Pletacka-IoT/Pletacka-board/README.md

# Pletacka-boad

## [Version 2.0](Pletacka-board-v2.0/README.md)

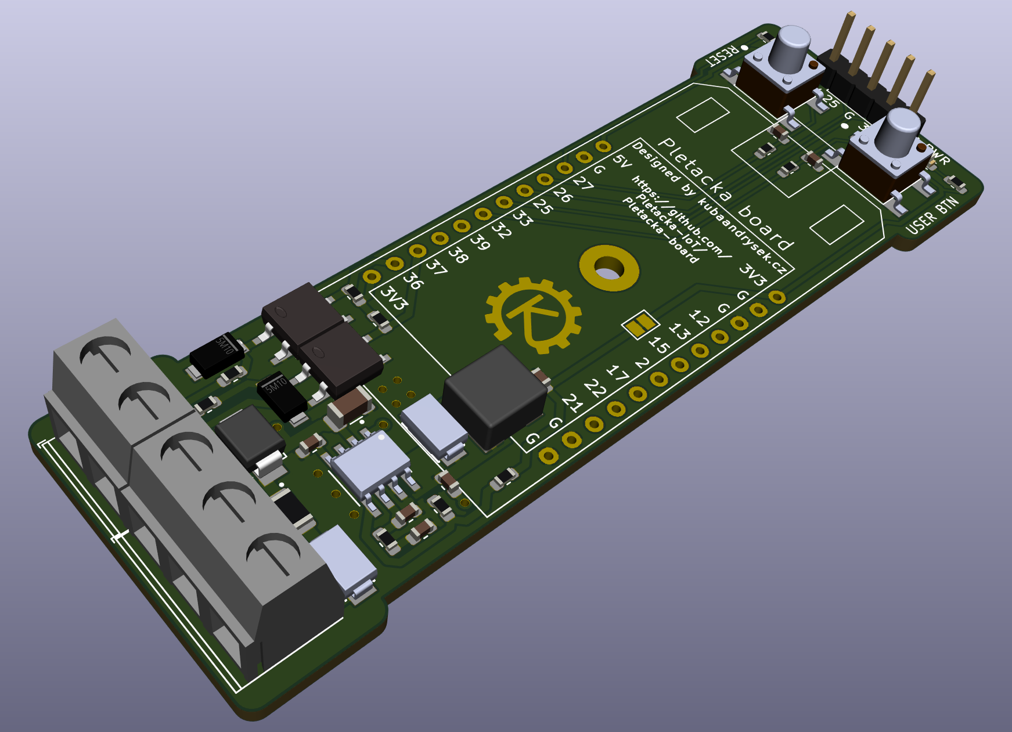
[picture p1: Pletacka-board-v2.0/media/P0.png]
Front

# [All photos](./Pletacka-board-v2.0/media/README.md)
