Pletacka-IoT/Pletacka-board/Pletacka-board-v2.0/README.md

# Pletacka-boad v2.0

## Export manufacturing data - Linux

Run `make` in console 

### Required packages
 - [KiKit](https://github.com/yaqwsx/KiKit#installation) Automation for KiCAD
 - [Python 3](https://www.python.org/downloads/)
