Pletacka-IoT/Pletacka-board/Pletacka-board-v2.0/media/README.md

## Version 2.0 - Images

Front
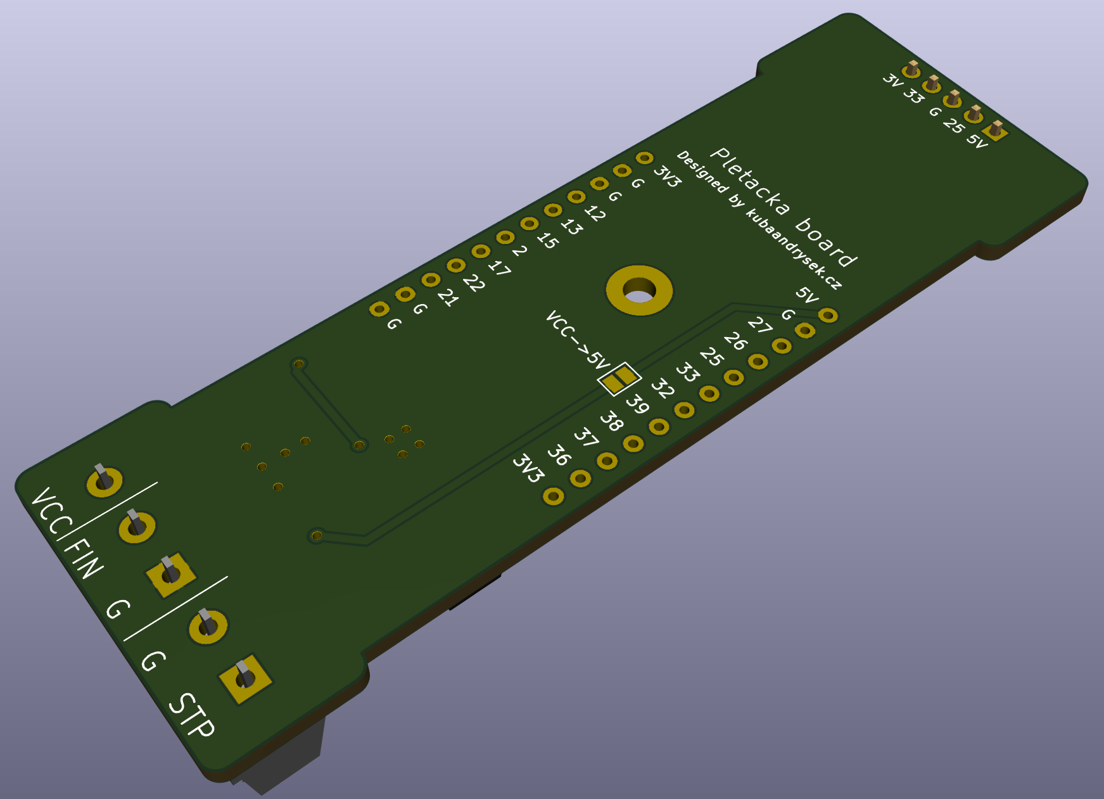
[picture p2: Pletacka-board-v2.0/media/P5.png]
Back


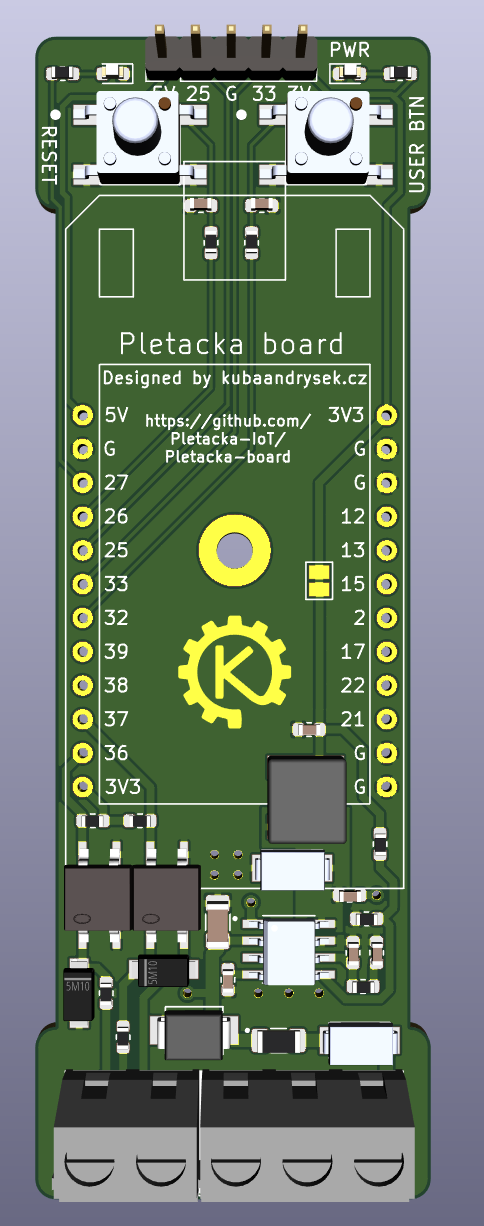
[picture p3: Pletacka-board-v2.0/media/P1.png]

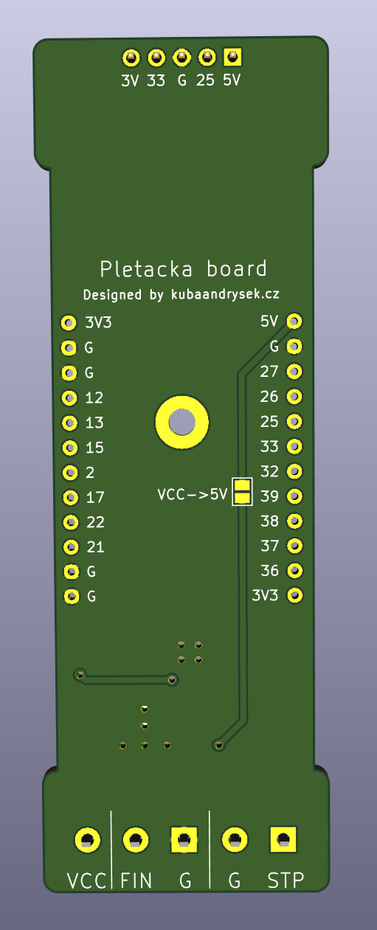
[picture p4: Pletacka-board-v2.0/media/P6.png]


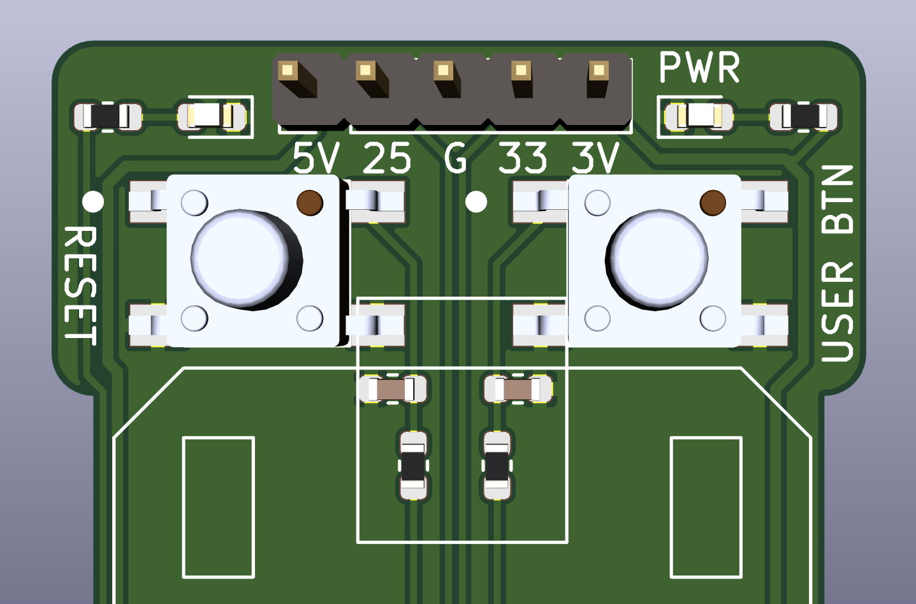
[picture p5: Pletacka-board-v2.0/media/P4.png]

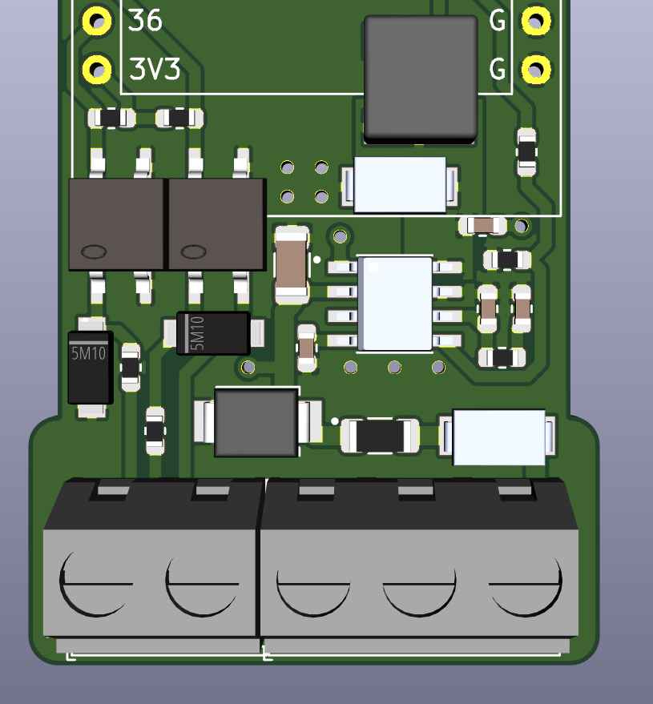
[picture p6: Pletacka-board-v2.0/media/P2.png]

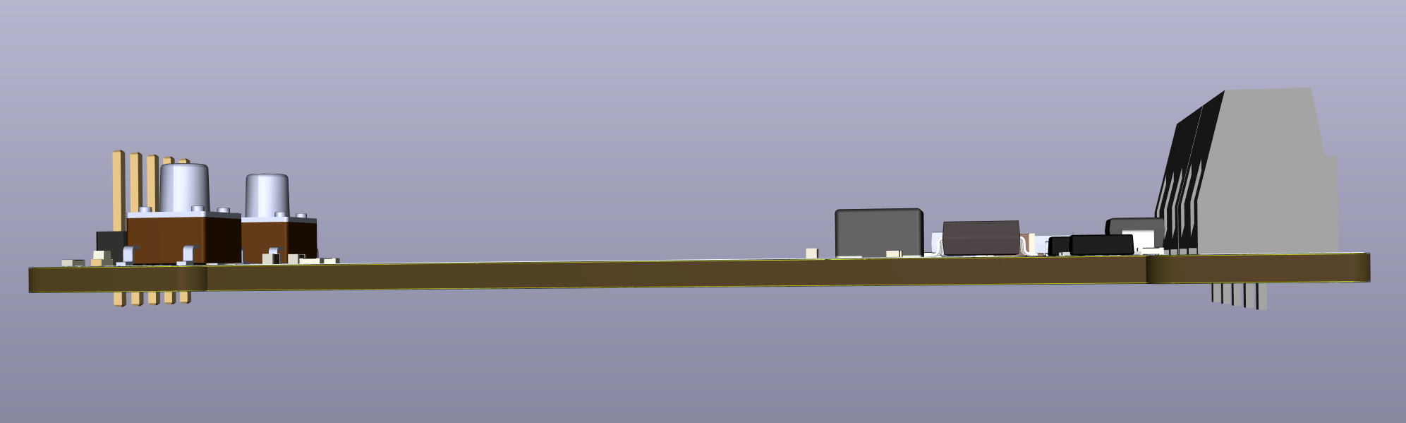
[picture p7: Pletacka-board-v2.0/media/P7.png]
