Pletacka-IoT/Pletacka-board/Pletacka-board-v2.0/media/P3.png

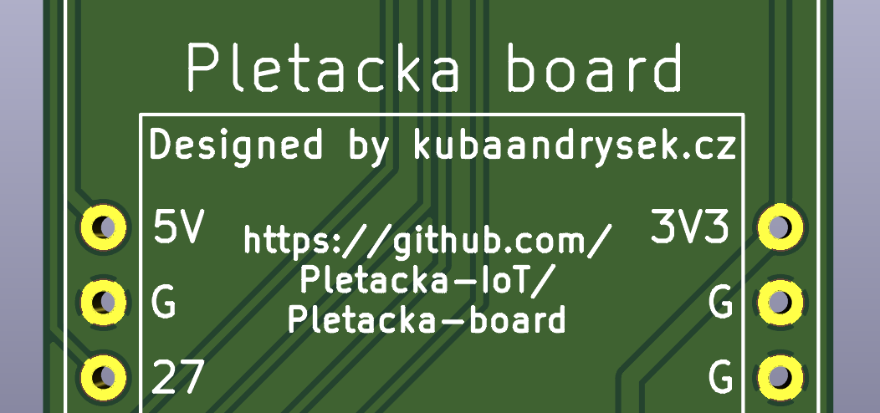
Pletacka-board-v2.0/media/P3.png
