Pletacka-IoT/Pletacka-board/Pletacka-board-v2.0/media/Pletacka_board-V2.png

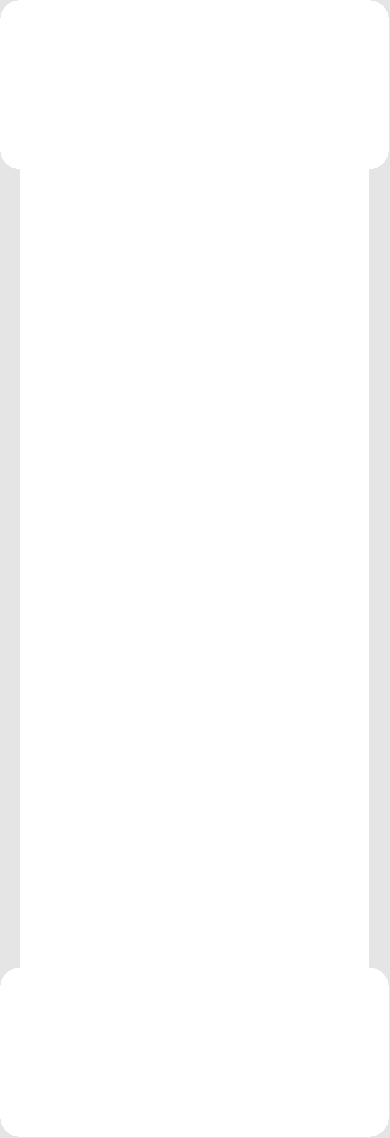
Pletacka-board-v2.0/media/Pletacka_board-V2.png
