Pletacka-IoT/Pletacka-board/Pletacka-board-v2.0/media/Routing_v2.0-2.png

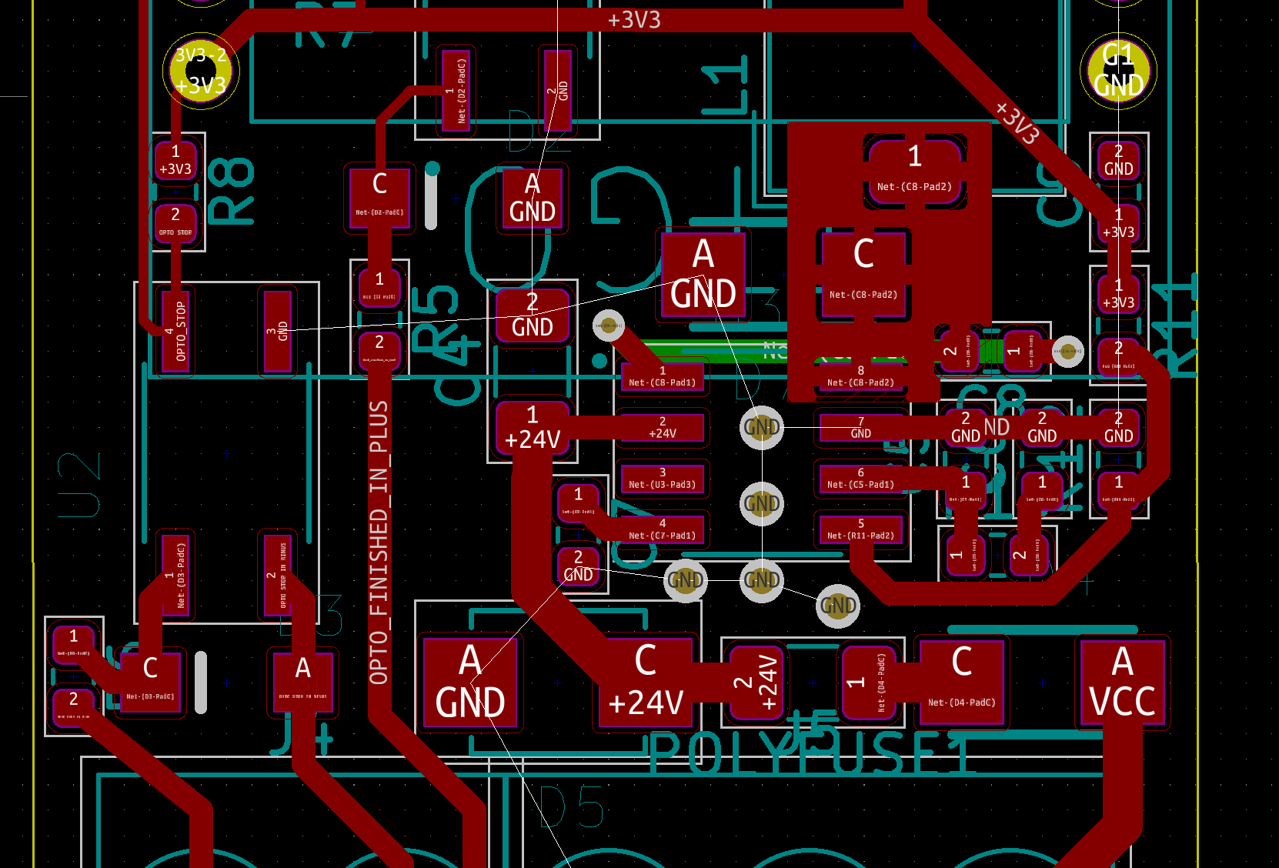
Pletacka-board-v2.0/media/Routing_v2.0-2.png
