Pletacka-IoT/Pletacka-board/Pletacka-board-v2.0/media/V2.0.png

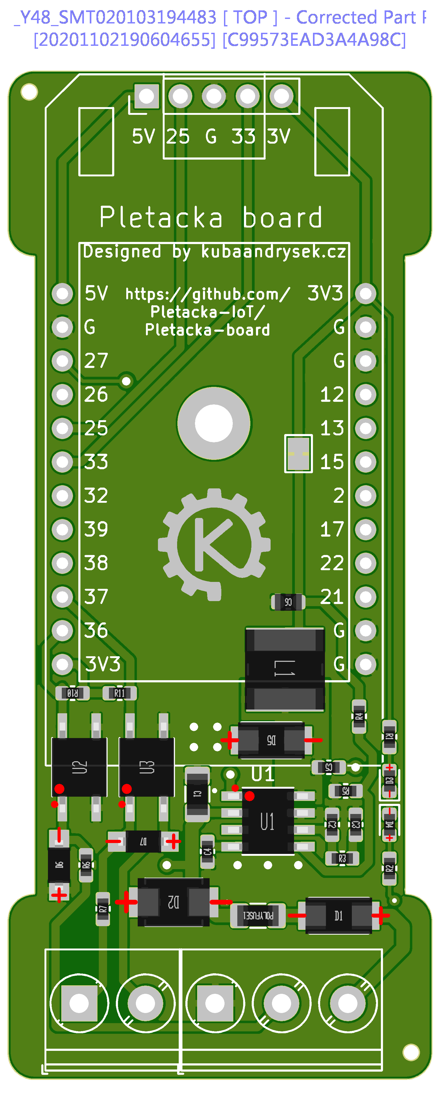
Pletacka-board-v2.0/media/V2.0.png
