Pletacka-IoT/Pletacka-board/Pletacka-board-v2.0/cover/Cover.stl

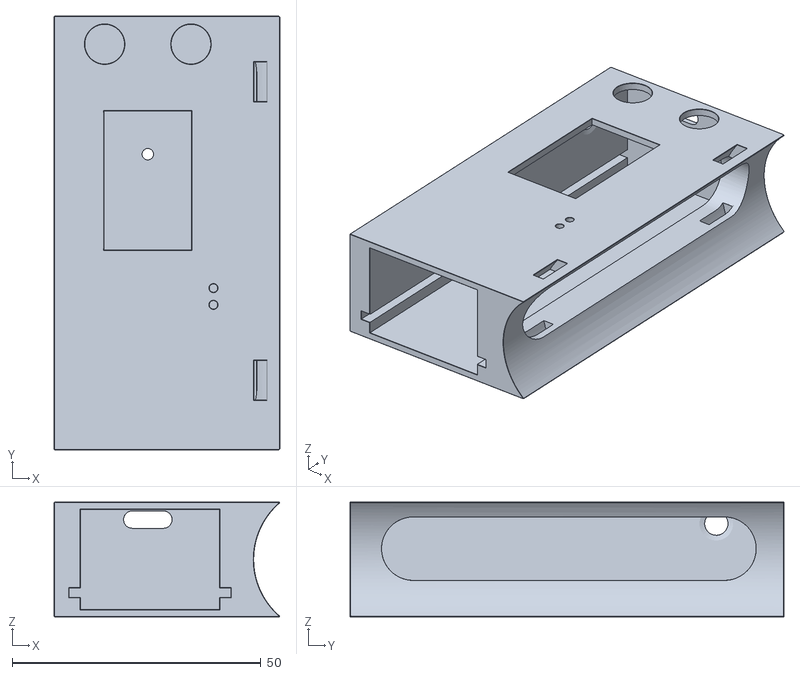
[picture p13: CAD file, 2020-12-12]
Pletacka-board-v2.0/cover/Cover.stl
45.3 x 87.2 x 23.1
