Pletacka-IoT/Pletacka-board/Pletacka-board-v2.0/cover/Button-reset.stl

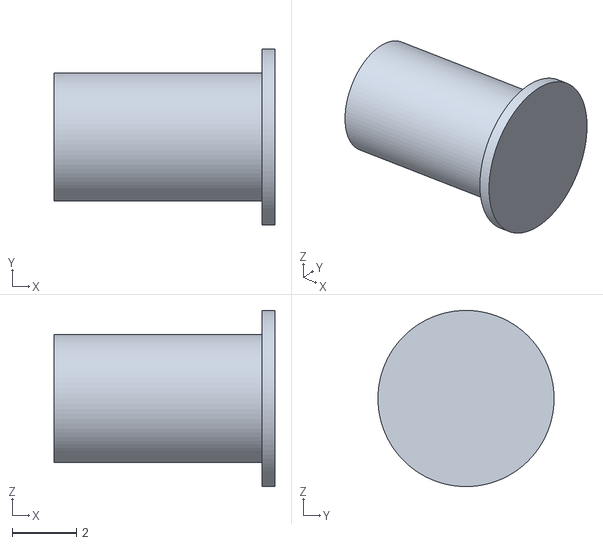
[picture p14: CAD file, 2020-12-12]
Pletacka-board-v2.0/cover/Button-reset.stl
6.90 x 5.50 x 5.50
