Pletacka-IoT/Pletacka-board/Pletacka-board-v2.0/cover/Holder-b.stl

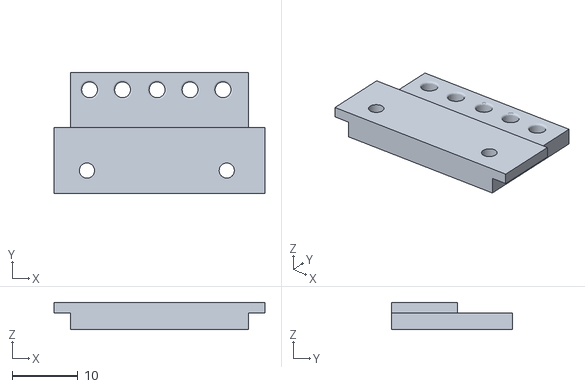
[picture p15: CAD file, 2020-12-12]
Pletacka-board-v2.0/cover/Holder-b.stl
32.0 x 18.4 x 4.10
