Pletacka-IoT/Pletacka-board/Pletacka-board-v2.0/cover/Holder-t.stl

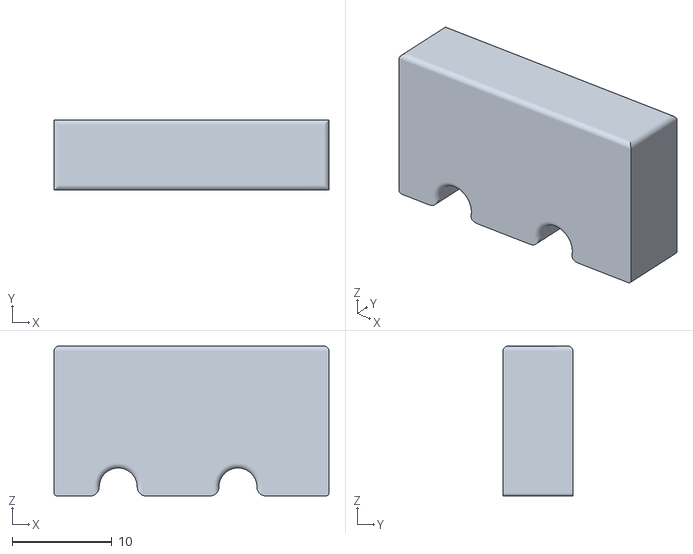
[picture p16: CAD file, 2020-12-12]
Pletacka-board-v2.0/cover/Holder-t.stl
27.5 x 7.00 x 15.0
