Pletacka-IoT/Pletacka-board/Pletacka-board-v2.0/cover/Button.stl

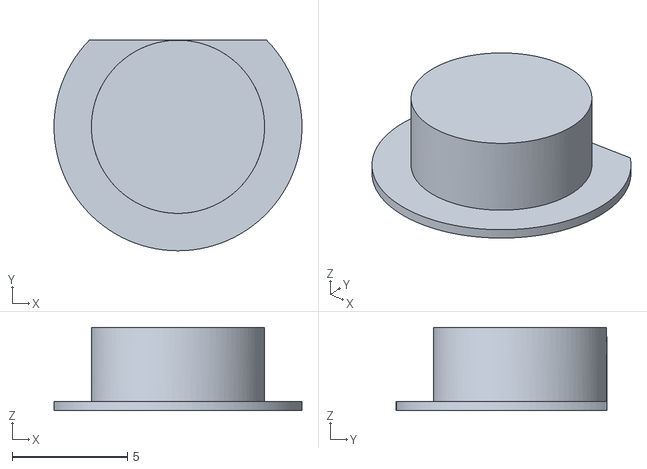
[picture p17: CAD file, 2020-12-12]
Pletacka-board-v2.0/cover/Button.stl
10.7 x 9.12 x 3.60
