Pletacka-IoT/Pletacka-board/Pletacka-board-v1.0/cover/3-covers-assembly.3mf

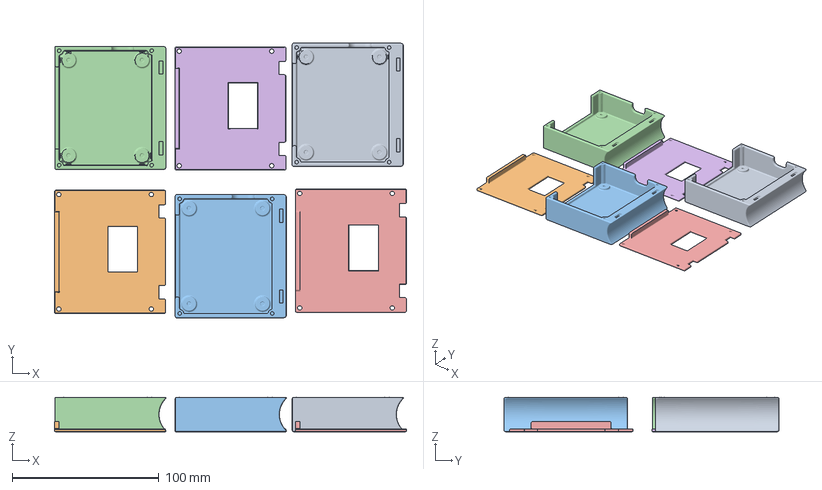
[picture p18: CAD file, 2020-10-28, an earlier design]
Pletacka-board-v1.0/cover/3-covers-assembly.3mf
239.8 x 187.1 x 23.5 mm
Cover.stl x 3
Cover-Top.stl x 3
