Pletacka-IoT/Pletacka-board/Pletacka-board-v1.0/cover/1-cover-assembly.3mf

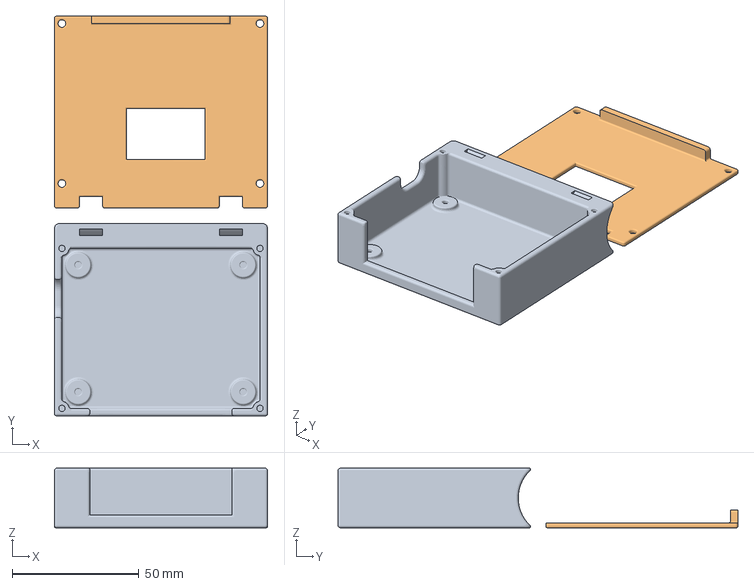
[picture p19: CAD file, 2020-10-24, an earlier design]
Pletacka-board-v1.0/cover/1-cover-assembly.3mf
84.0 x 157.5 x 23.5 mm
Cover.stl
Cover-Top.stl
