Pletacka-IoT/Pletacka-board/Pletacka-board-v1.0/cover/Cover-Top.stl

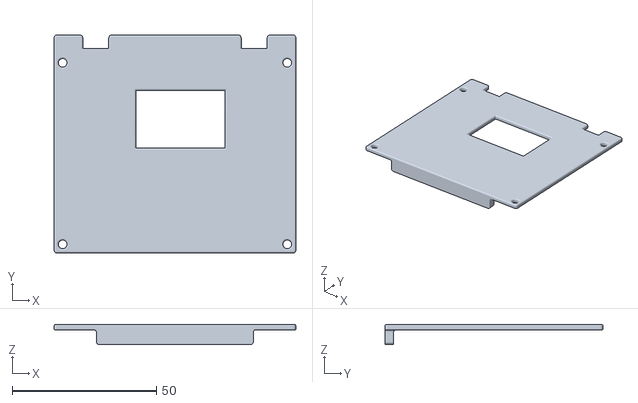
[picture p20: CAD file, 2020-10-24, an earlier design]
Pletacka-board-v1.0/cover/Cover-Top.stl
84.0 x 75.7 x 7.00
