Pletacka-IoT/Pletacka-board/Pletacka-board-v1.0/cover/Cover.stl

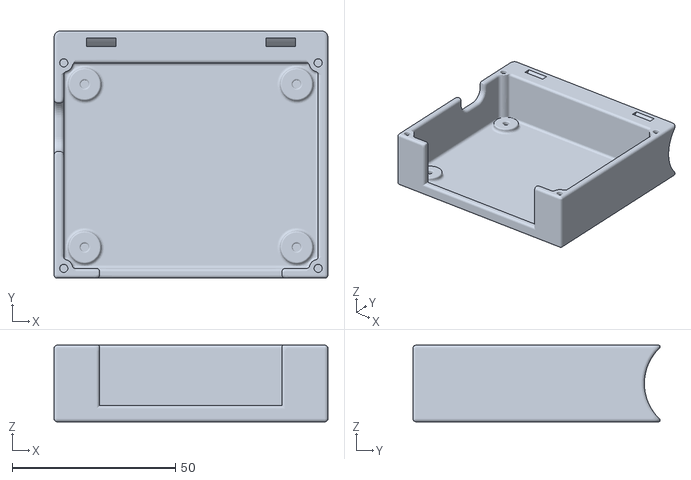
[picture p21: CAD file, 2020-10-24, an earlier design]
Pletacka-board-v1.0/cover/Cover.stl
84.0 x 75.8 x 23.5
