Pletacka-IoT/Pletacka-board/(threads)

Thread 10 (2020-08-10):

Restrict around mounting holes only from one side

cednik, 2020-08-10:
Is it okay?

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

JakubAndrysek, 2020-08-11:
Fixed

Closed 2020-08-11.

Thread 11 (2020-08-10):

Add JLCPCB order number and tooling holes

cednik, 2020-08-10:
Consider add [location of JLCPCB order number](https://support.jlcpcb.com/article/28-how-to-put-jlc-production-id-at-a-specified-area-on-the-pcb) and [SMT assembly Tooling holes](https://support.jlcpcb.com/article/92-how-to-add-tooling-holes-for-smt-assembly-order).

Closed 2020-08-11.

Thread 13 (2020-08-10):

Step-down undorvoltage threshold

cednik, 2020-08-10:
Step-down undorvoltage threshold is set to 13.75 V (by R14 and R15). Is it correct?

JakubAndrysek, 2020-08-11:
Is it correct?
What voltage you would recommended.

JakubAndrysek, 2020-08-12:
Fixed

Closed 2020-08-12.

Thread 14 (2020-08-10):

Missing pull-up resistors on I2C

cednik, 2020-08-10:
I suggest to add them.

Closed 2020-08-11.

Thread 15 (2020-08-10):

USB not at the board edge

cednik, 2020-08-10:
In case of boxing the device, USB connector should be at the board edge.

JakubAndrysek, 2020-08-11:
I will fix it in the next version

Thread 2 (2020-08-10):

Inssuficient power rating of input resistors

cednik, 2020-08-10:
Expected input voltage U = 24 V
Figure 1 in the [optocoupler datasheet](https://datasheet.lcsc.com/szlcsc/Everlight-Elec-EL357N-B-TA-G_C6649.pdf) shows Forward voltage Vf ≈ 1.2 V @ 10 mA (24 V / 2 kΩ).
So power loss on the input resistor (R6, R8, R10, R12) P = (U - Vf)² × R = (24 - 1.2)² × 2000 = 259.92 mW, which is more then designed 0.25 W!
The situation is even worse in case of reversed polarity - voltage drop accros diode B5819W is smaller.

**Suggestion:**
Lower the emitor current to only 1 mA.

Closed 2020-08-10.

Thread 3 (2020-08-10):

Insufficient voltage rating of step-down output capacitor

cednik, 2020-08-10:
Read [this](https://www.murata.com/en-global/products/%20emiconfun/capacitor/2012/11/28/en-20121128-p1) article from [Murata](https://www.murata.com/) (major capacitors vendor).

This is Capacitance change rate vs. DC bias voltage characteristics of 6.3 V capacitor. Especially blue line - your case.
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
[[1](https://www.murata.com/-/media/webrenewal/products/emiconfun/capacitor/2012/11/28/en-20121128-p1/en-20121128-p1_img0001.ashx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)]
You can see that at 5 V the capacitor has only half of it's nominal capacity.

**Suggestion**
Use capacitor rated at least at 16 V.

Closed 2020-08-10.

Thread 7 (2020-08-10):

Power LED should be on by default

cednik, 2020-08-10:
And ESP can turn it off, but by default it shoult indicate presence of the power.

**Suggestion**
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

JarekParal, 2020-08-10:
There should be PWR LED used as ESP start-up indicator. Not a power indicator.

**Suggestion**
`PWR` -> `ON`

Closed 2020-08-10.
