Pletacka-IoT/Pletacka-board/Pletacka-board-v2.0/hw/Pletacka-board.kicad_pcb

## KiCad design Pletacka-board-v2.0/hw/Pletacka-board.kicad_pcb (2020-10-25)

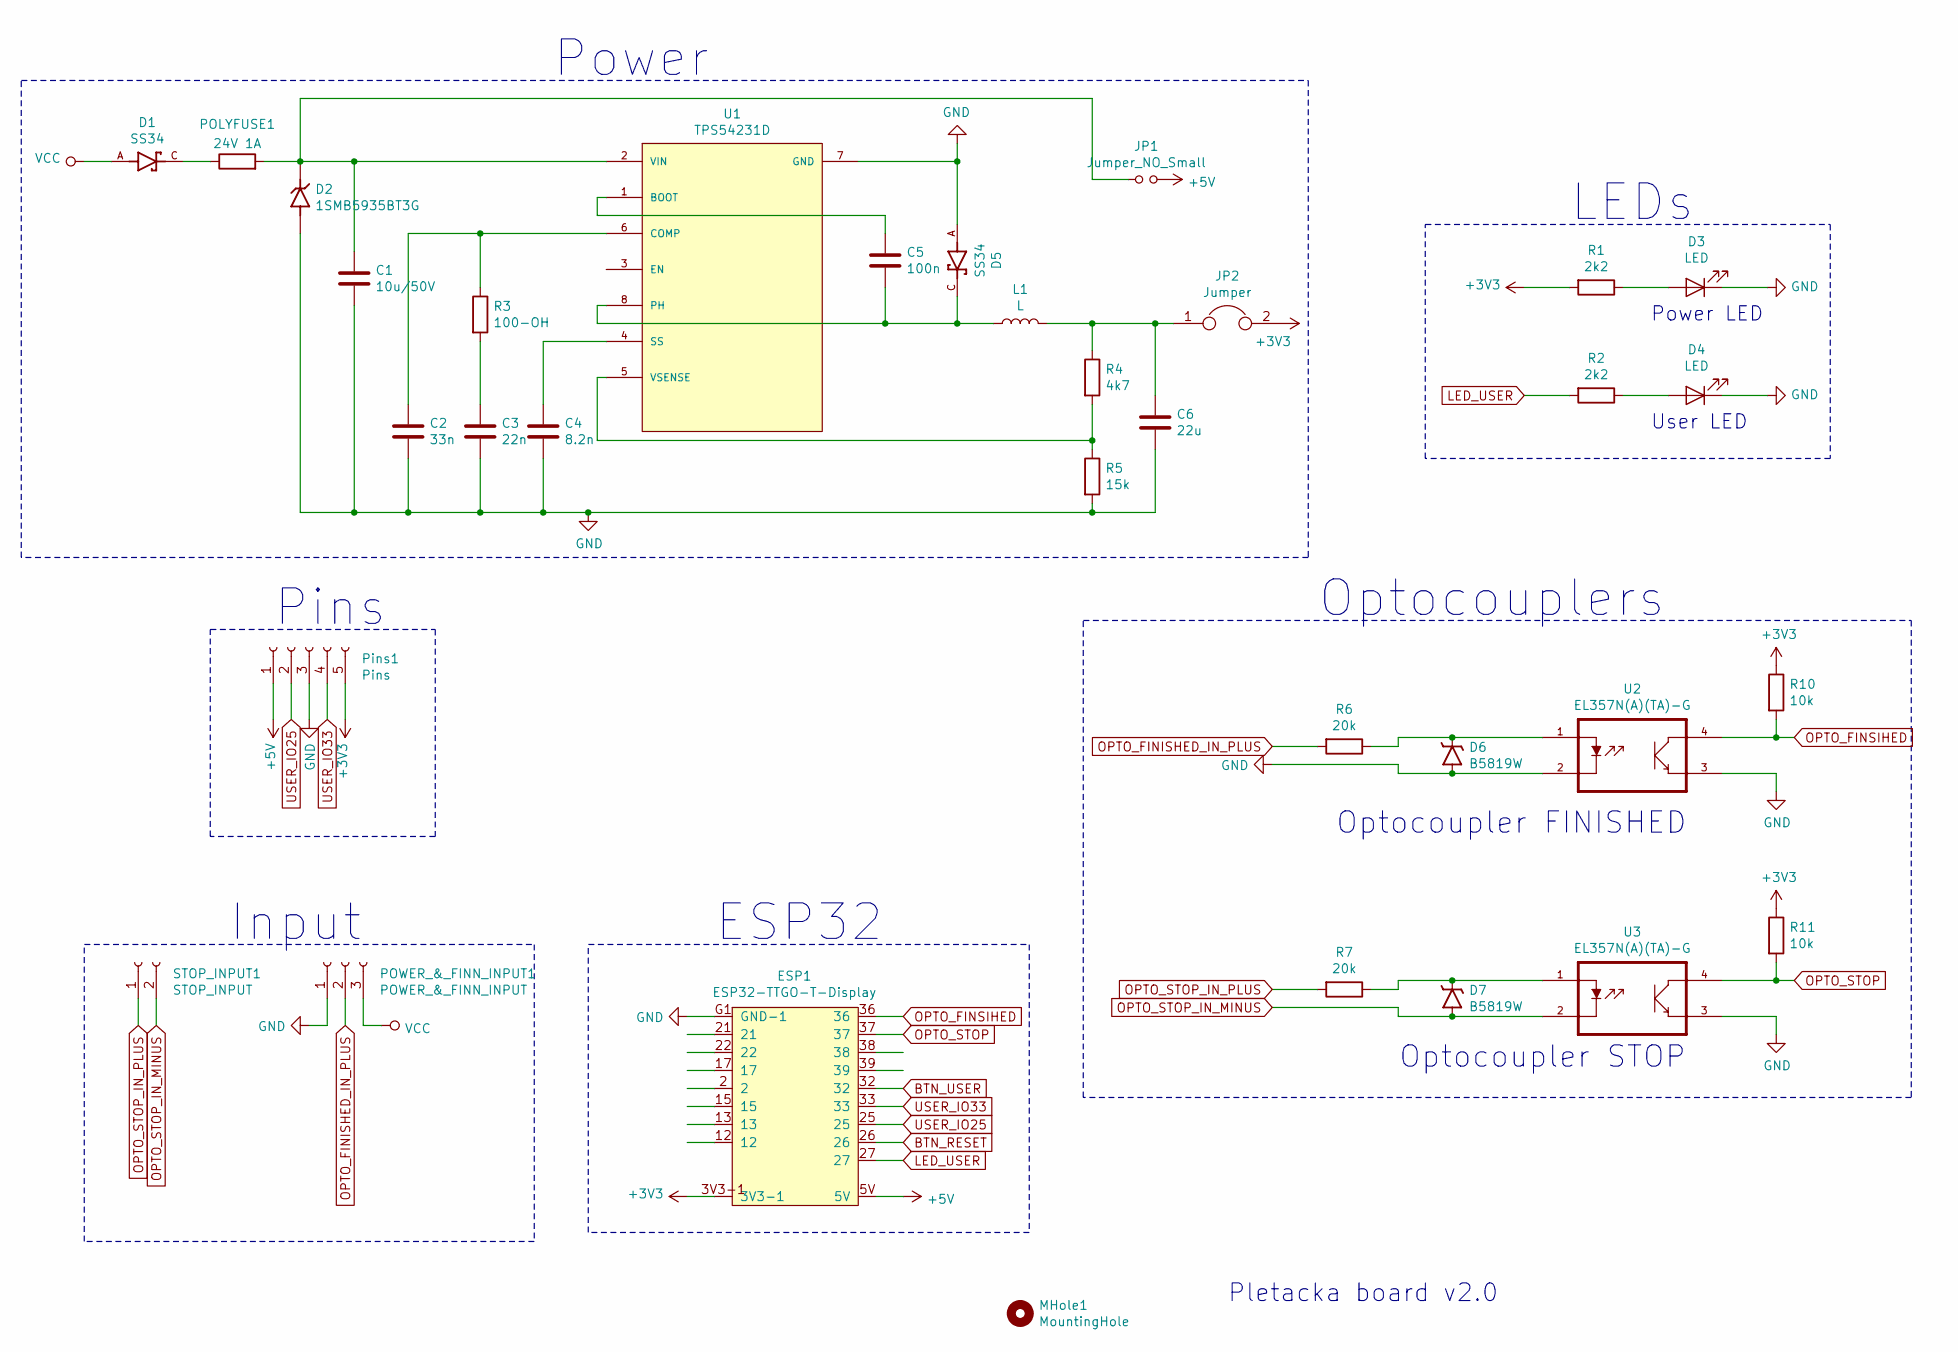
[picture p22: schematic Pletacka-board.sch]

Parts:
C1: 10u/50V; C_1206_3216Metric; LCSC C13585
C2: 33n; C_0603_1608Metric; LCSC C21117
C3: 22n; C_0603_1608Metric; LCSC C21122
C4: 8.2n; C_0603_1608Metric; LCSC C1032
C5: 100n; C_0603_1608Metric; LCSC C14663
C6: 22u; C_0603_1608Metric; LCSC C45783
D1, D5: SS34; SMA; LCSC C8678
D2: 1SMB5935BT3G; DIOM5436X247N; LCSC C49827
D3: LED; LED_0603_1608Metric; LCSC C72043
D4: LED; LED_0603_1608Metric; LCSC C2286
D6, D7: B5819W; B5819W_SOD-123; LCSC C8598
ESP1: ESP32-TTGO-T-Display
JP1: Jumper_NO_Small; SolderJumper-2_P1.3mm_Open_Pad1.0x1.5mm
JP2: Jumper; SolderJumper-2_P1.3mm_Bridged_Pad1.0x1.5mm
L1: L; SLW; LCSC C206321
MHole1: MountingHole; MountingHole_2.7mm_M2.5_Pad
POLYFUSE1: 24V 1A; R_1206_3216Metric; LCSC C70076
POWER_&_FINN_INPUT1: POWER_&_FINN_INPUT; TerminalBlock_Phoenix_PT-1,5-3-5.0-H_1x03_P5.00mm_Horizontal
Pins1: Pins; PinHeader_1x05_P2.54mm_Vertical
R1, R2: 2k2; R_0603_1608Metric; LCSC C4190
R3: 100-OH; R_0603_1608Metric; LCSC C22775
R4: 4k7; R_0603_1608Metric; LCSC C23162
R5: 15k; R_0603_1608Metric; LCSC C22809
R6, R7: 20k; R_0603_1608Metric; LCSC C4184
R10, R11: 10k; R_0603_1608Metric; LCSC C25804
STOP_INPUT1: STOP_INPUT; TerminalBlock_Phoenix_PT-1,5-2-5.0-H_1x02_P5.00mm_Horizontal
U1: TPS54231D; SOIC127P599X175-8N; LCSC C9865
U2, U3: EL357N(A)(TA)-G; SOP254P700X200-4N; LCSC C6649

Connections:
+3V3: ESP1.3V3-1, ESP1.3V3-2, JP2.2, Pins1.5, R1.2, R10.1, R11.1
+5V: ESP1.5V, JP1.2, Pins1.1
BTN_RESET: ESP1.26
BTN_USER: ESP1.32
GND: C1.2, C2.2, C3.2, C4.2, C6.2, D2.A, D3.1 (K), D4.1 (K), D5.A, D6.A, ESP1.G1 (GND-1), ESP1.G2 (GND-2), ESP1.G3 (GND-3), ESP1.G4 (GND-4), ESP1.G5 (GND-5), POWER_&_FINN_INPUT1.1, Pins1.3, R5.2, U1.7 (GND), U2.2, U2.3, U3.3
LED_USER: ESP1.27, R2.2
unnamed: C1.1, D2.C, JP1.1, POLYFUSE1.2, U1.2 (VIN)
unnamed: C2.1, R3.1, U1.6 (COMP)
unnamed: C3.1, R3.2
unnamed: C4.1, U1.4 (SS)
unnamed: C5.1, U1.1 (BOOT)
unnamed: C5.2, D5.C, L1.1, U1.8 (PH)
unnamed: C6.1, JP2.1, L1.2, R4.1
unnamed: D1.C, POLYFUSE1.1
unnamed: D3.2 (A), R1.1
unnamed: D4.2 (A), R2.1
unnamed: D6.C, R6.1, U2.1
unnamed: D7.C, R7.1, U3.1
unnamed: R4.2, R5.1, U1.5 (VSENSE)
OPTO_FINISHED_IN_PLUS: POWER_&_FINN_INPUT1.2, R6.2
OPTO_FINSIHED: ESP1.36, R10.2, U2.4
OPTO_STOP: ESP1.37, R11.2, U3.4
OPTO_STOP_IN_MINUS: D7.A, STOP_INPUT1.2, U3.2
OPTO_STOP_IN_PLUS: R7.2, STOP_INPUT1.1
USER_IO25: ESP1.25, Pins1.2
USER_IO33: ESP1.33, Pins1.4
VCC: D1.A, POWER_&_FINN_INPUT1.3

Notes on the sheet:
Input
Optocoupler FINISHED
Optocoupler STOP
Power
Optocouplers
ESP32
Pletacka board v2.0
Pins
User LED
Power LED
LEDs

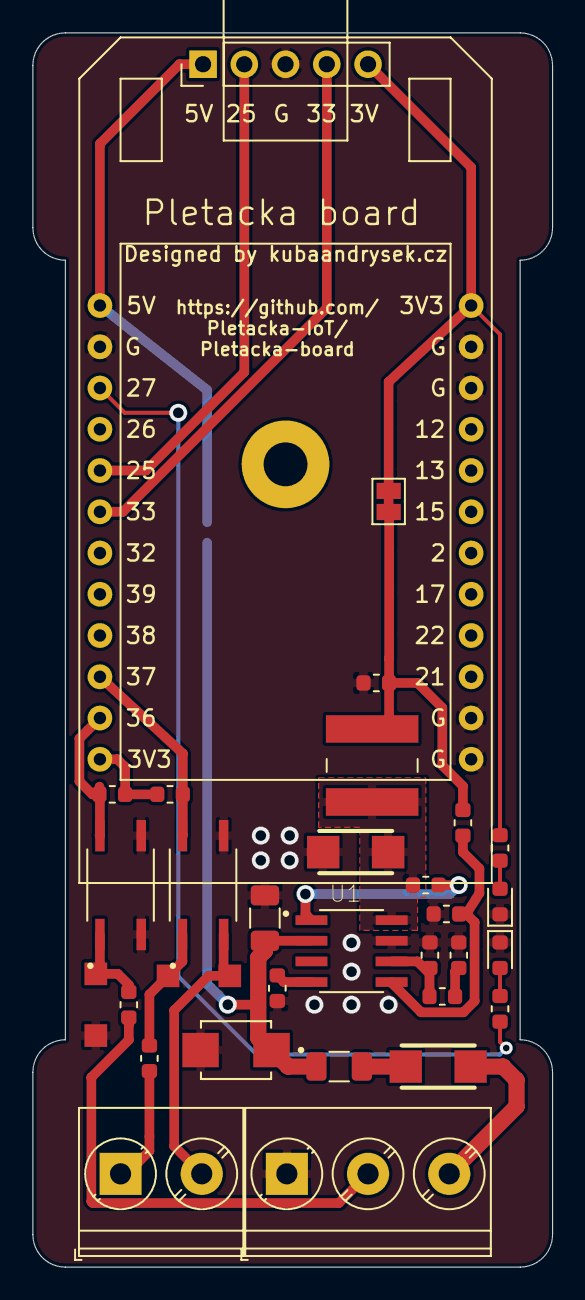
[picture p23: board Pletacka-board.kicad_pcb from above]

Board: 2 copper layers, 32.0 x 76.0 mm, 34 parts (1 on the bottom side), 25 nets.
