Pletacka-IoT/Pletacka-board/Pletacka-board-v1.0/hw/Pletacka_board.brd

## EAGLE design Pletacka-board-v1.0/hw/Pletacka_board.brd (2020-08-12, an earlier design)

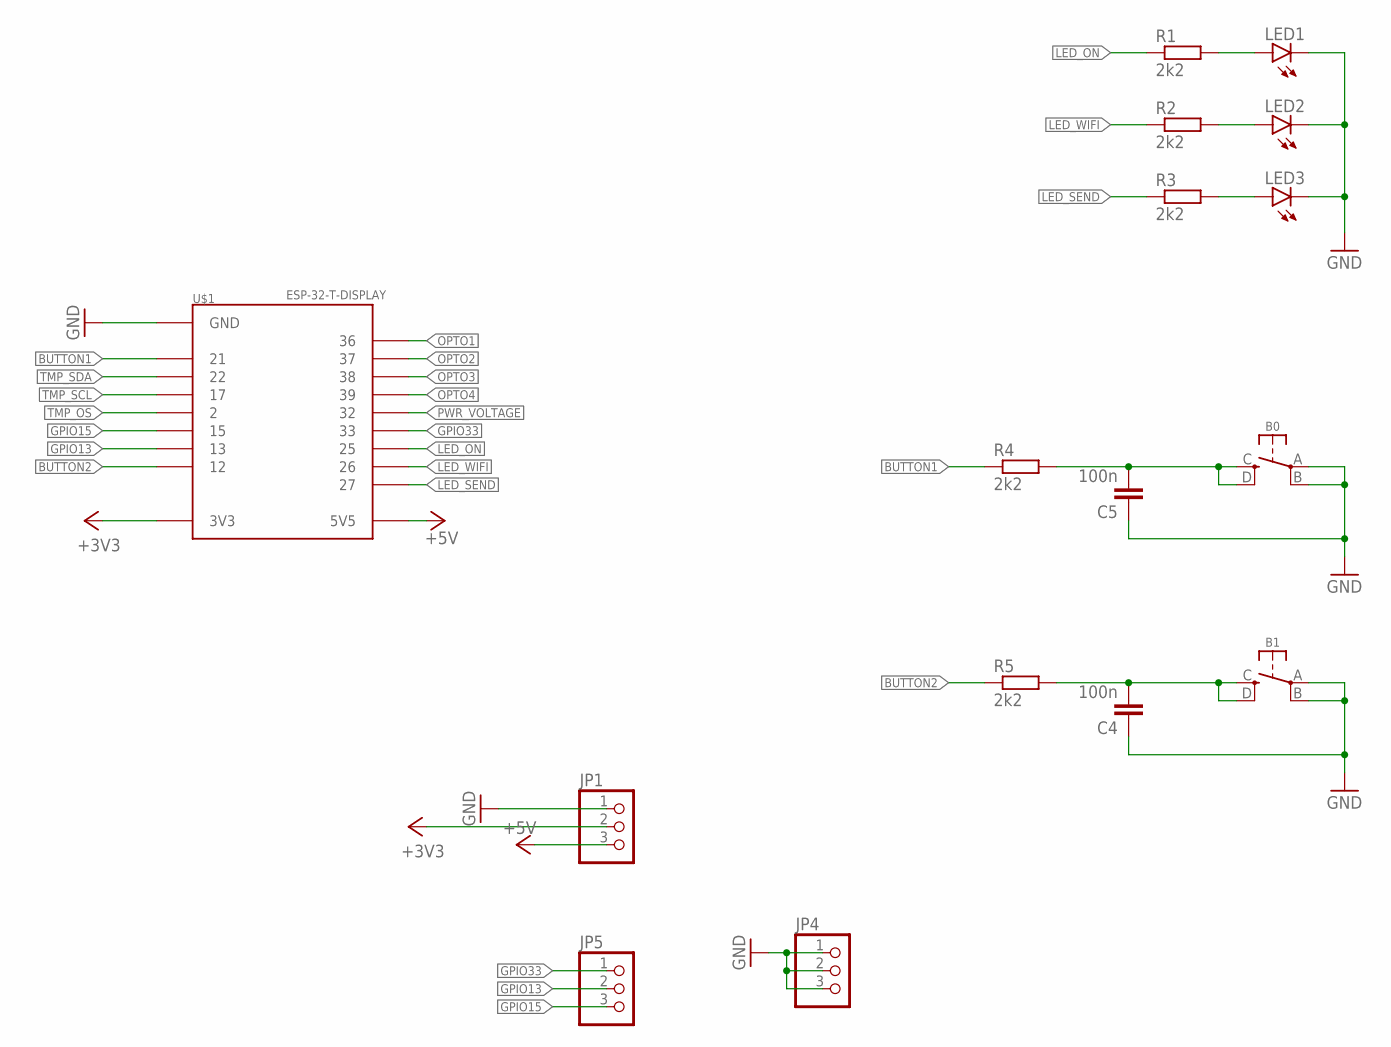
[picture p24: schematic Pletacka_board.sch, sheet 1, ESP32 + UI]

Parts:
B0: ENTER; TS-1187A; LCSC_ID C318888
B1: B1; TS-1187A; LCSC_ID C318888
C4, C5: 100n; C0603; LCSC_ID C14663
JP1, JP4, JP5: PINHD-1X3; 1X03
LED1, LED2, LED3: LEDCHIPLED_0603; CHIPLED_0603; LCSC_ID C2286
R1, R2, R3, R4, R5: 2k2; R0603; LCSC_ID C4190
U$1: ESP-32-T-DISPLAY; ESP32-T-DISPLAY

Connections:
+3V3: JP1.2, U$1.3V3, U$1.3V3-2 (3V3); also elsewhere on the board
+5V: JP1.3, U$1.5V (5V5); also elsewhere on the board
BUTTON1: R4.1, U$1.21
BUTTON2: R5.1, U$1.12
GND: B0.A, B0.B (P1), B1.A, B1.B (P1), C4.1, C5.1, JP1.1, JP4.1, JP4.2, JP4.3, LED1.C, LED2.C, LED3.C, U$1.G-1 (GND), U$1.G-2 (GND), U$1.G-3 (GND), U$1.G-4 (GND), U$1.G-5 (GND); also elsewhere on the board
GPIO13: JP5.2, U$1.13
GPIO15: JP5.3, U$1.15
GPIO33: JP5.1, U$1.33
LED_ON: R1.1, U$1.25
LED_SEND: R3.1, U$1.27
LED_WIFI: R2.1, U$1.26
unnamed: LED1.A, R1.2
unnamed: LED2.A, R2.2
unnamed: B0.C (S), B0.D (S1), C5.2, R4.2
unnamed: B1.C (S), B1.D (S1), C4.2, R5.2
unnamed: LED3.A, R3.2
OPTO1: U$1.36; also elsewhere on the board
OPTO2: U$1.37; also elsewhere on the board
OPTO3: U$1.38; also elsewhere on the board
OPTO4: U$1.39; also elsewhere on the board
PWR_VOLTAGE: U$1.32; also elsewhere on the board
TMP_OS: U$1.2; also elsewhere on the board
TMP_SCL: U$1.17; also elsewhere on the board
TMP_SDA: U$1.22; also elsewhere on the board

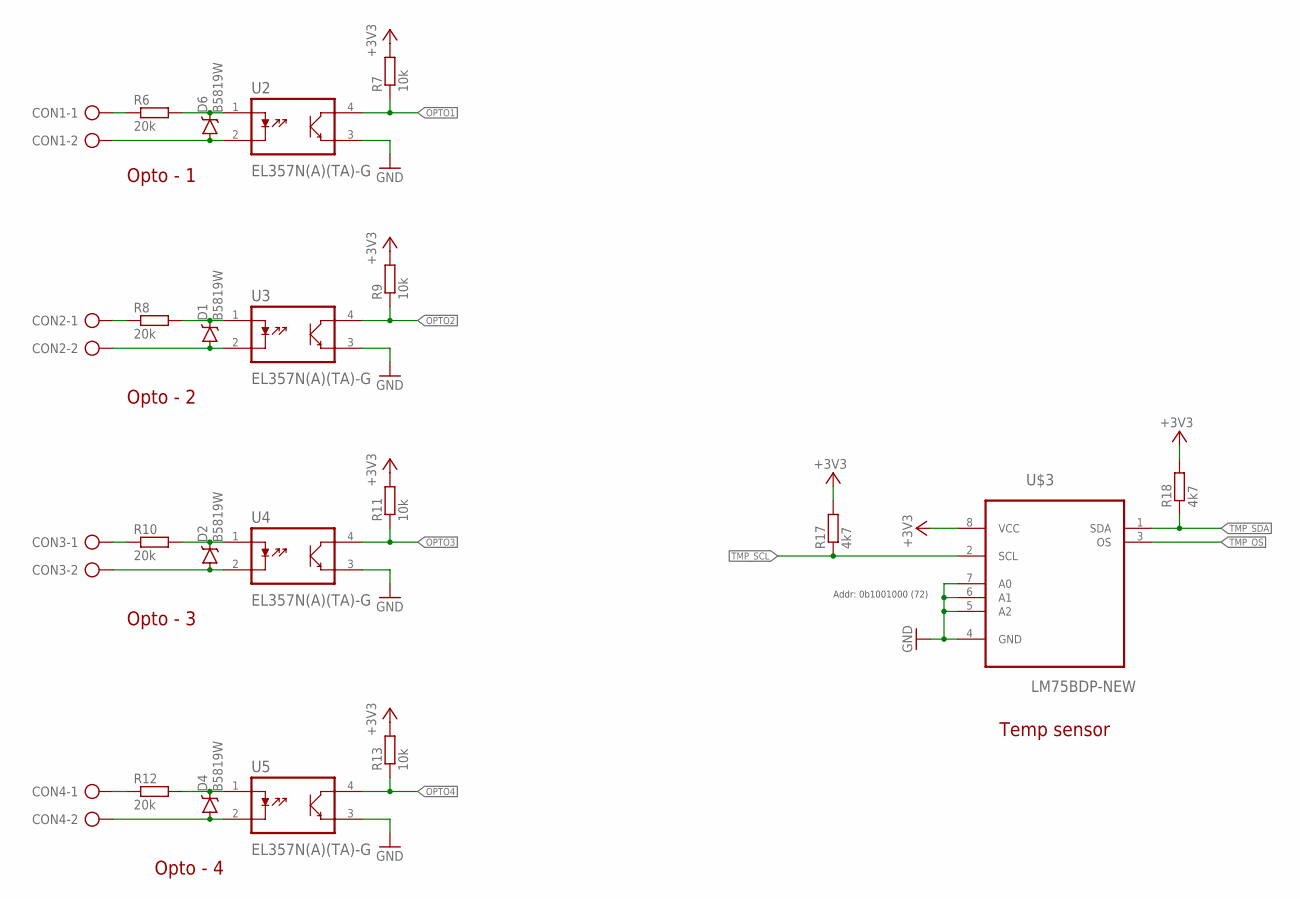
[picture p25: schematic Pletacka_board.sch, sheet 2, Sensors]

Parts:
CON1, CON2, CON3, CON4: AK500/2
D1, D2, D4, D6: B5819W; SOD-123; LCSC_ID C8598
R6, R8, R10, R12: 20k; R0603; LCSC_ID C4184
R7, R9, R11, R13: 10k; R0603; LCSC_ID C25804
R17, R18: 4k7; R0603; LCSC_ID C23162
U2, U3, U4, U5: EL357N(A)(TA)-G; SOP254P700X200-4N; LCSC_ID C6649
U$3: LM75BDP-NEW; SOT505-1; LCSC_ID C33099

Connections:
+3V3: R7.2, R9.2, R11.2, R13.2, R17.2, R18.2, U$3.8 (VCC); also elsewhere on the board
GND: U2.3 (E), U3.3 (E), U4.3 (E), U5.3 (E), U$3.4 (GND), U$3.5 (A2), U$3.6 (A1), U$3.7 (A0); also elsewhere on the board
unnamed: CON1.1, R6.1
unnamed: CON1.2, D6.A, U2.2 (K)
unnamed: D6.C, R6.2, U2.1 (A)
unnamed: CON2.1, R8.1
unnamed: CON2.2, D1.A, U3.2 (K)
unnamed: D1.C, R8.2, U3.1 (A)
unnamed: CON3.1, R10.1
unnamed: CON3.2, D2.A, U4.2 (K)
unnamed: D2.C, R10.2, U4.1 (A)
unnamed: CON4.1, R12.1
unnamed: CON4.2, D4.A, U5.2 (K)
unnamed: D4.C, R12.2, U5.1 (A)
OPTO1: R7.1, U2.4 (C); also elsewhere on the board
OPTO2: R9.1, U3.4 (C); also elsewhere on the board
OPTO3: R11.1, U4.4 (C); also elsewhere on the board
OPTO4: R13.1, U5.4 (C); also elsewhere on the board
TMP_OS: U$3.3 (OS); also elsewhere on the board
TMP_SCL: R17.1, U$3.2 (SCL); also elsewhere on the board
TMP_SDA: R18.1, U$3.1 (SDA); also elsewhere on the board

Notes on the sheet:
Opto - 1
Opto - 2
Opto - 3
Opto - 4
Temp sensor
Addr: 0b1001000 (72)

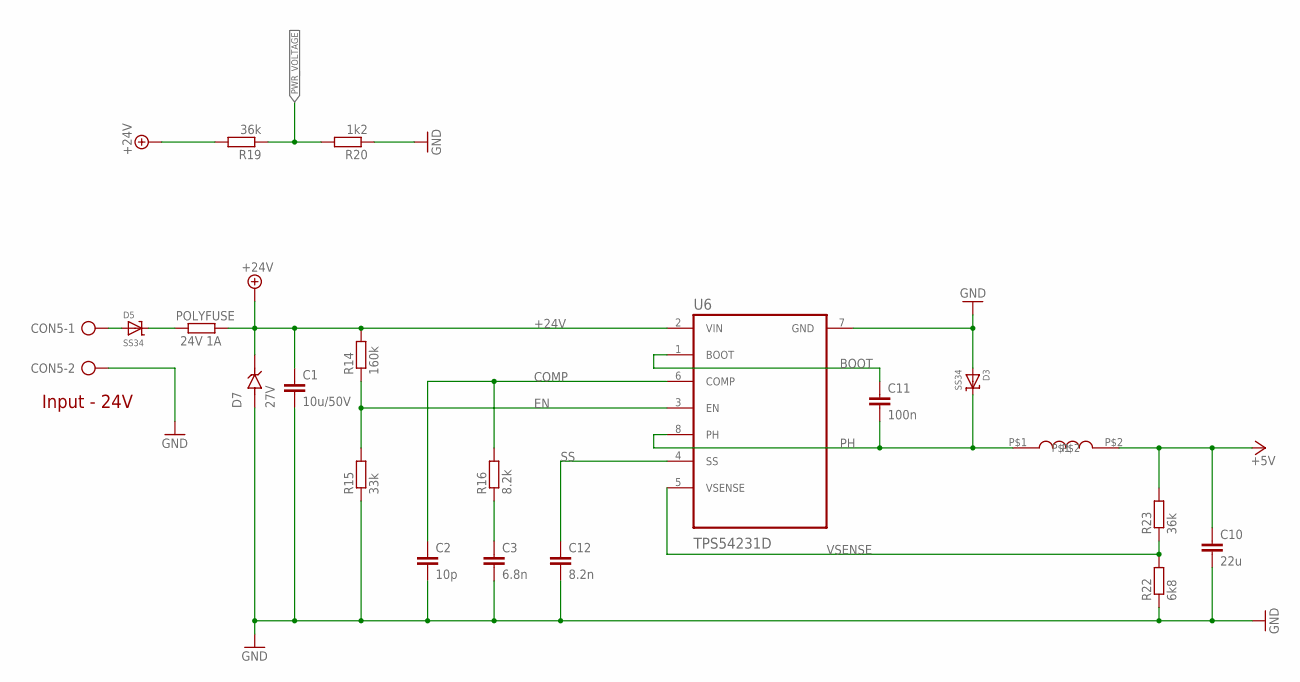
[picture p26: schematic Pletacka_board.sch, sheet 3, Power]

Parts:
C1: 10u/50V; C1206; LCSC_ID C13585
C2: 10p; C0603; LCSC_ID C1634
C3: 6.8n; C0603; LCSC_ID C1631
C10: 22u; C0805; LCSC_ID C45783
C11: 100n; C0603; LCSC_ID C14663
C12: 8.2n; C0603; LCSC_ID C27920
CON5: AK500/2
D3, D5: SS34; SMA; LCSC_ID C8678
D7: 27V; DIOM5436X247N; LCSC_ID C49827
POLYFUSE: 24V 1A; R1206; LCSC_ID C70076
R14: 160k; R0603; LCSC_ID C22813
R15: 33k; R0603; LCSC_ID C4216
R16: 8.2k; R0603; LCSC_ID C25981
R19, R23: 36k; R0603; LCSC_ID C23147
R20: 1k2; R0603; LCSC_ID C22765
R22: 6k8; R0603; LCSC_ID C23212
U6: TPS54231D; SOIC127P599X175-8N; LCSC_ID C28023
U$2: SWRB1204S; LCSC_ID C169399

Connections:
+5V: C10.1, R23.2, U$2.P$2; also elsewhere on the board
+24V: C1.1, D7.C (K), POLYFUSE.1, R14.2, R19.2, U6.2 (VIN)
BOOT: C11.1, U6.1 (BOOT)
COMP: C2.1, R16.2, U6.6 (COMP)
EN: R14.1, R15.2, U6.3 (EN)
GND: C1.2, C2.2, C3.2, C10.2, C12.2, CON5.2, D3.A, D7.A, R15.1, R20.1, R22.1, U6.7 (GND); also elsewhere on the board
unnamed: CON5.1, D5.A
unnamed: D5.C, POLYFUSE.2
unnamed: C3.1, R16.1
PH: C11.2, D3.C, U6.8 (PH), U$2.P$1
PWR_VOLTAGE: R19.1, R20.2; also elsewhere on the board
SS: C12.1, U6.4 (SS)
VSENSE: R22.2, R23.1, U6.5 (VSENSE)

Notes on the sheet:
Input - 24V

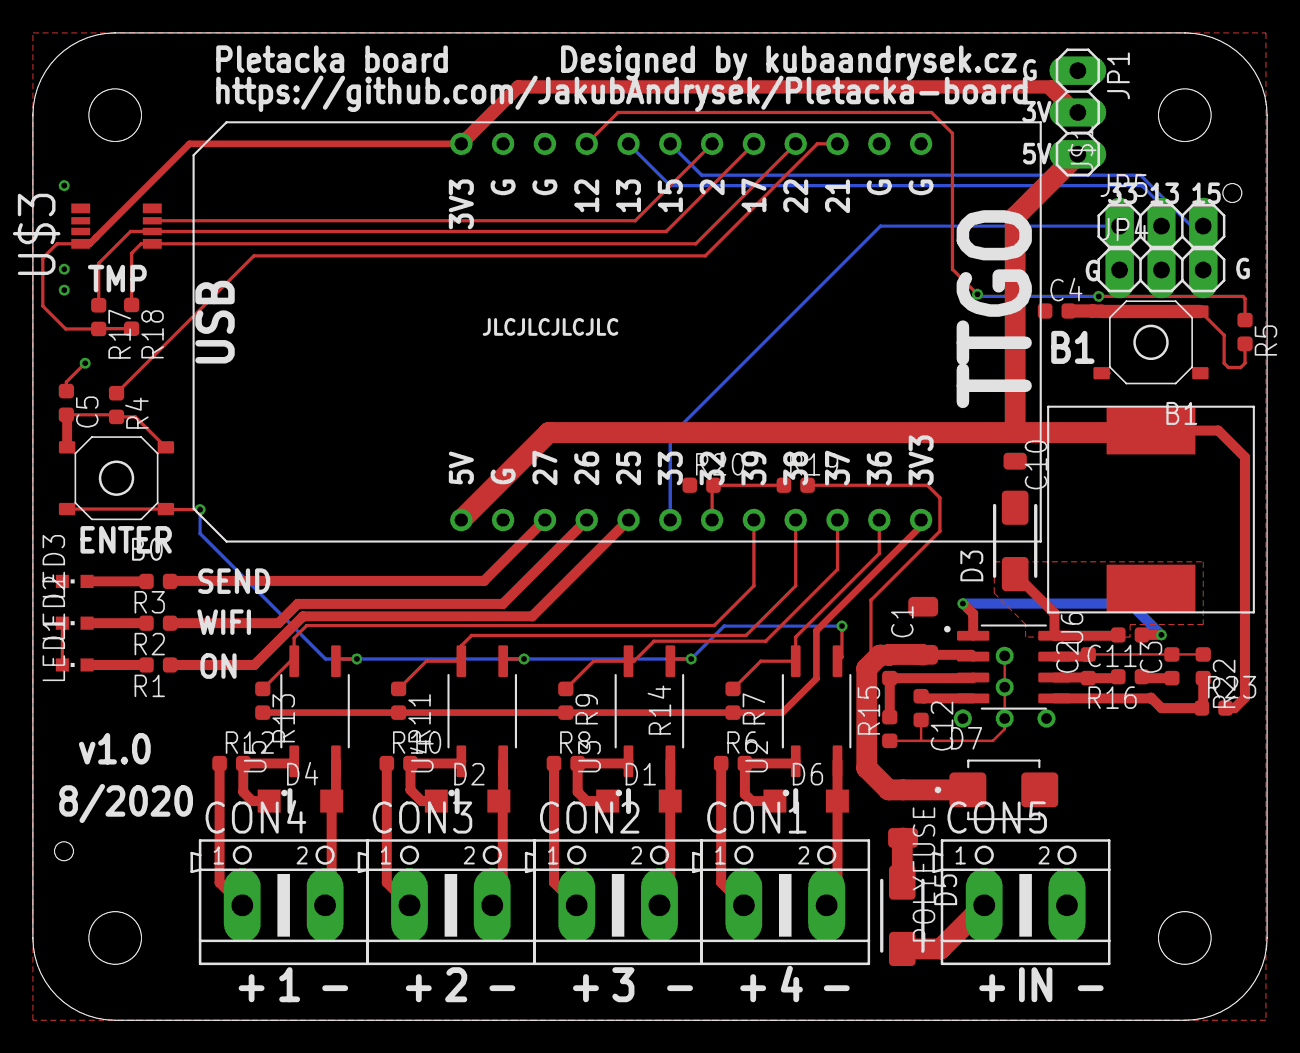
[picture p27: board Pletacka_board.brd from above]

Board: 2 copper layers, 75.0 x 60.0 mm, 59 parts (0 on the bottom side), 46 nets.
