Pletacka-IoT/Pletacka-board/hw/Pletacka-boardR.sch

## KiCad design hw/Pletacka-boardR.sch (2020-10-19)

Schematic: Pletacka-boardR.sch

Parts:
C1: 10u/50V; C_1206_3216Metric; LCSC_ID C13585
C2: 33n; C_0603_1608Metric; LCSC_ID C21117
C3: 22n; C_0603_1608Metric; LCSC_ID C21122
C4: 8.2n; C_0603_1608Metric; LCSC_ID C1032
C5, C7, C8: 100n; C_0603_1608Metric; LCSC_ID C14663
C6: 22u; C_0603_1608Metric; LCSC_ID C45783
D1, D5: SS34; SMA; LCSC_ID C8678
D2: 1SMB5935BT3G; DIOM5436X247N; LCSC_ID C49827
D3: LED; LED_0603_1608Metric; LCSC_ID C72043
D4: LED; LED_0603_1608Metric; LCSC_ID C2286
D6, D7: B5819W; B5819W_SOD-123; LCSC_ID C8598
E1: ESP32-TTGO-T-Display
H1: MountingHole; MountingHole_2.7mm_M2.5_Pad
J4: STOP_INPUT; TerminalBlock_Phoenix_PT-1,5-2-5.0-H_1x02_P5.00mm_Horizontal
J5: POWER_&_FINN_INPUT; TerminalBlock_Phoenix_PT-1,5-3-5.0-H_1x03_P5.00mm_Horizontal
L1: L; L_TDK_SLF7045
POLYFUSE1: 24V 1A; R_1206_3216Metric; LCSC_ID C70076
R1, R2, R8, R9: 2k2; R_0603_1608Metric; LCSC_ID C4190
R3: 100-OH; R_0603_1608Metric; LCSC_ID C22775
R4: 4k7; R_0603_1608Metric; LCSC_ID C23162
R5: 15k; R_0603_1608Metric; LCSC_ID C22809
R6, R7: 20k; R_0603_1608Metric; LCSC_ID C4184
R10, R11: 10k; R_0603_1608Metric; LCSC_ID C25804
SW1: Reset_Button; Button_SMD_10mm; LCSC_ID C318887
SW2: User_Button; Button_SMD_10mm; LCSC_ID C318887
U1: TPS54231D; SOIC127P599X175-8N; LCSC_ID C9865
U2, U3: EL357N(A)(TA)-G; SOP254P700X200-4N; LCSC_ID C6649

Notes on the sheet:
Input
Optocoupler FINISHED
Optocoupler STOP
Power
Optocouplers
Buttons
ESP32
LEDs
Pletacka board v2.0
Reset button
User button
Power LED
User LED
