Pletacka-IoT/Pletacka-board/Pletacka-board-v2.0/sw/Pletacka-board-v2.0.2/src/main.cpp

/**
 * @file main.cpp
 * @author Jakub Andrýsek (email@kubaandrysek.cz)
 * @brief 
 * @version 0.1
 * @date 2020-08-14
 * 
 * @copyright Copyright (c) 2020 Jakub Andrýsek
 * 
 * @link https://kubaandrysek.cz
 */

#include <Arduino.h>
#include "Pletacka.hpp"
#include "BasicOTA.hpp"
#include <SPI.h>
#include "WiFi.h"
#include "ArduinoMetronome.hpp"
#include "Board_tester.hpp"
#include "rbprotocol.h"


void mainProgram()
{
	//Main setup

	PletackaConfig config;
	config.serverUrl = "http://192.168.0.2/api/v1/thisSensor/add-event";
	config.serverUrlBackup = "http://192.168.0.2/Backup/api/v1/thisSensor/add-event";
	// config.wifiName = "Pletacka-IoT";
	// config.wifiPassword = "PletackaPlete";
	// config.wifiName = "WLRotex";
	config.wifiName = "WLOffice";
	config.wifiPassword = "$BlueC6r&R06D";
	// config.wifiName = "Suzand";
	// config.wifiPassword = "Pucini.13";
	// config.wifiName = "Technika";
	// config.wifiPassword = "materidouska";
	config.udpIP = "192.168.0.2";
	config.udpPort = 2727;
	// config.debugOn = true;


	// Uncoment for testing 
	// Board_tester tester;
	// tester.test(&config, pProt);


	BasicOTA ota;
	Pletacka pletacka;
	WiFiClass pWiFi;
	ArduinoMetronome statusMetronome(10);
	ArduinoMetronome buttonMetronome(1000);
	ArduinoMetronome displayMetronome(1000);
	ArduinoMetronome wifiTester(1000);
	ArduinoMetronome aliveMetronome(10000);
	
	// Serial.printf("main pPro %d", pProt);
	pletacka.config(&config);




	statusMetronome.startupDelayMs(14000);
	// displayMetronome.startupDelayMs(15000);
	displayMetronome.startupDelayMs(5000);
	aliveMetronome.startupDelayMs(1000);
	wifiTester.startupDelayMs(3000);
	// buttonMetronome.startupDelayMs(15000);
	buttonMetronome.startupDelayMs(15000);

	
	ota.begin();
	
	
	pletacka.ui()->println("Version: "+ String(IOT_VERSION)); 
	pletacka.ui()->debugln("Version: "+ String(IOT_VERSION));


	int ledSend = 0;
	bool ledWifiState = false;
	int startAlive = 0;


	//Main loop
	while (true)
	{
		ota.handle();

		
		//	Status loop [10ms]
		if(statusMetronome.loopMs())
		{
			
			String status = "";
			static bool offLedState = false;

			
			if((status = pletacka.isChange())!= "")
			{
				ledSend = millis();
				digitalWrite(LED_SEND, true);
				pletacka.ui()->println("Status: " + status);
				pletacka.ui()->showStatus(status);
				pletacka.ui()->updateInfo(status);
				pletacka.ui()->showInfo();
				pletacka.sendState(status);
				offLedState = true;
				
			}

			if(millis()-ledSend > 4000 && offLedState)
			{
				offLedState = false;
				digitalWrite(LED_SEND, false);
				pletacka.ui()->hideStatus();
				pletacka.ui()->UIoffLeds();
			}


			
		}

		//	Send alive loop [10s]
		if(aliveMetronome.loopMs())
		{			
			startAlive = millis();
			pletacka.sendAlive(config.sensorNumber);
		}
		
		//	WiFi connection test loop [1s]
		if(wifiTester.loopMs())
		{			
			if(pWiFi.status() != WL_CONNECTED)
			{
				ledWifiState = !ledWifiState;
				pletacka.ui()->showError("Not connected to WiFi"); 
				pletacka.ui()->showMsg("WiFi ERROR");
				delay(2000);
				pletacka.ui()->showStatus("RESTART...");
				delay(3000);
				ESP.restart(); 
			}
		}



		//	Dsiplay loop [1s]
		if(displayMetronome.loopMs())
		{			
			pletacka.ui()->showInfo();
		}	


		//	Set ID loop [1s]
		if(buttonMetronome.loopMs())
		{			
			pletacka.buttonPush();
		}		
		
	}
	
}



void setup() {
	mainProgram();
}

void loop() {}
