Pletacka-IoT/Pletacka-board/Pletacka-board-v2.0/sw/Pletacka-board-v2.0.2/src/Pletacka.hpp

# pragma once

#include <Arduino.h>

#include "NetteApi.hpp"
#include "Pletacka_config.hpp"
#include "Pletacka_UI.hpp"
#include "Pletacka_wifi.hpp"
#include "Pletacka_status.hpp"
#include "Pletacka_alive.hpp"

// #include "gridui.h"
// #include "rbprotocol.h"
// #include "rbwebserver.h"
// #include "rbwifi.h"

// using namespace rb;
// using namespace gridui;

#define ADC_EN          14
#define ADC_PIN         34
#define BUTTON_1        35
#define BUTTON_2        0 

class Pletacka
{
private:
	Pletacka_UI UI;

	PletackaConfig* pCfg = NULL;
	Pletacka_wifi pletacka_wifi;
	Pletacka_status pletacka_status;
	Pletacka_alive pletacka_alive;
	NetteApi apiState;
	NetteApi apiStateBackup;


	Protocol* pProt = nullptr;



public:
	Pletacka();
	~Pletacka();
	void config(PletackaConfig* config);	

	String isChange();
	void sendState(String state);
	void sendAlive(int sensorNumber);
	void editSensorNumber();	
	void buttonPush();
	Pletacka_UI* ui() {return &UI;}

};
