Pletacka-IoT/Pletacka-board/Pletacka-board-v2.0/sw/Pletacka-board-v2.0.2/src/Pletacka_status.hpp

#pragma once

#include <Arduino.h>
#include "Pletacka_config.hpp"
#include "Optocoupler.hpp"
#include "Pletacka_UI.hpp"

class Pletacka_status
{
private:
    
    Optocoupler optoStop; 
	Optocoupler optoFinish; 
    

    struct Optocuplrs
    {
        bool stop;
        bool finish;
    }opto;


    enum states
    {
        SSTOP = 1,
        SFINISHED = 0,
    };

    enum pletac_run
    {
        DEF = -1,
        ON = 0,
        STOP = 1, 
        FINISHED = 2,
    };    



	Pletacka_UI* UI = nullptr;
	PletackaConfig cfg;
    
    

public:

    void init(PletackaConfig* config, Pletacka_UI* inUI);
    String getStatus();
    
};
