Pletacka-IoT/Pletacka-board/Pletacka-board-v2.0/sw/Pletacka-board-v2.0.2/src/Board_tester.cpp

#include "Board_tester.hpp"
#include "Pletacka.hpp"
#include "Optocoupler.hpp"


void Board_tester::test(PletackaConfig* cfg, rb::Protocol *pPro)
{
    
	

	WiFi::connect(cfg->wifiName.c_str(), cfg->wifiPassword.c_str());
	
	UI.init(cfg);
	
	UI.showMsg("Start testing");


    pinMode(LED_SEND, OUTPUT);
    pinMode(BTN_UP, INPUT);
    pinMode(BTN_DOWN, INPUT);

    pinMode(PWR_VOLTAGE, INPUT);

    Optocoupler opt_F(OP_1_FINISH);
    Optocoupler opt_S(OP_2_STOP);    

    delay(1500);  


    UI.showMsg("LEDS");


    digitalWrite(LED_SEND, true);
    delay(300);
    digitalWrite(LED_SEND, false);
    delay(300);


    UI.showMsg("Press button:");

    // UI.showStatus("ENTER");
    // while(digitalRead(BTN_ENTER)){}
    // delay(500);
    
    UI.showStatus("UP");
    while(digitalRead(BTN_UP)){}
    delay(500);
    
    UI.showStatus("DOWN");
    while(digitalRead(BTN_DOWN)){}
    delay(500);

    UI.showStatus("OK");
    delay(500);





    UI.showMsg("Optocoupler:");

    
    UI.showStatus("OP-1 FINISH");
    while(!opt_F.state()){}
    delay(500);

    UI.showStatus("OP-2 STOP");
    while(!opt_S.state()){}
    delay(500);



    UI.showStatus("OK");
    delay(500);



	UI.showStatus("Test end");

    while (1)
	{
		;
	}
	
}
