Pletacka-IoT/Pletacka-board/Pletacka-board-v2.0/sw/Pletacka-board-v2.0.2/src/Board_tester.hpp

#pragma once

#include <Arduino.h>
#include "rbprotocol.h"
#include "Pletacka_UI.hpp"
#include "Pletacka_config.hpp"

using namespace rb;

class Board_tester
{
    private:
		Pletacka_UI UI;
		// Protocol* pProt = nullptr;

    public:
        void test(PletackaConfig* cfg, rb::Protocol *pPro);
   
};
