Pletacka-IoT/Pletacka-board/(commit log)

2020-06-18 Start creating board
    [Pletacka-board.brd, Pletacka-board.sch]
2020-06-18 Add buttons and LEDs
    [Pletacka-board.brd, Pletacka-board.sch]
2020-06-18 Add temperature sensor
    [Pletacka-board.brd, Pletacka-board.sch]
2020-06-19 Start routing
    [Pletacka-board.brd, Pletacka-board.sch]
2020-06-19 One more time from start
    [Pletacka-board.brd, Pletacka-board.sch]
2020-06-19 Start new project
    [Pletacka_board.brd, Pletacka_board.sch]
2020-06-19 Add LEDs, RFID, Temp sen.
    [Pletacka_board.brd, Pletacka_board.sch]
2020-06-19 Add Buttons + optocouplers
    [Pletacka_board.brd, Pletacka_board.sch]
2020-07-23 Start power management
    [Pletacka_board.brd, Pletacka_board.sch]
2020-08-09 Route power supply
    [Pletacka_board.brd]
2020-08-09 Finish first routing
    [Pletacka-board.sch, Pletacka_board.brd, Pletacka_board.sch]
2020-08-09 Add 2 pinheads
    [Pletacka_board.brd, Pletacka_board.sch]
2020-08-09 Fix Cednik's issues
    [Pletacka_board.brd, Pletacka_board.sch]
2020-08-10 Start fixing
    [Pletacka_board.brd, Pletacka_board.sch]
2020-08-10 Fix all atributes (fix #12)
    [Pletacka_board.brd, Pletacka_board.sch]
2020-08-10 Change octocoupler resistor to 20k (close #2)
    [Pletacka_board.brd, Pletacka_board.sch]
2020-08-10 Change step-down voltage (close #4)
    [Pletacka_board.brd, Pletacka_board.sch]
2020-08-10 Change package of capacitor to 0805 (close #3)
    [Pletacka_board.brd, Pletacka_board.sch]
2020-08-10 Edit buttons lables (close #16)
    [Pletacka_board.brd, Pletacka_board.sch]
2020-08-10 Fix power supply routing (close #5 and close #6)
    [Pletacka_board.brd]
2020-08-10 Rename POWER to ON (close #7)
    [Pletacka_board.brd]
2020-08-10 Fix ON button schema name
    [Pletacka_board.brd, Pletacka_board.sch]
2020-08-10 Add PS reverse polarity & over. pr. (close #8)
    [Pletacka_board.brd, Pletacka_board.sch]
2020-08-11 Improve schema for step-down input
    - improve readability of over-voltage protection in schema
    - fix some minor issues (LCSC_IDs, ...)
    [Pletacka_board.brd, Pletacka_board.sch]
2020-08-11 Fix Beware of tombstoning (close #9)
    [Pletacka_board.brd, Pletacka_board.sch]
2020-08-11 Add JLCPCB order n. and tooling holes (close #11)
    [Pletacka_board.brd]
2020-08-11 Add pull-up resistors on I2C (close #14)
    [Pletacka_board.brd, Pletacka_board.sch]
2020-08-11 Add input power voltage mesurement
    [Pletacka_board.brd, Pletacka_board.sch]
2020-08-11 Move voltage mesurement resistors
    [Pletacka_board.brd]
2020-08-12 Update resistor R15
    [Pletacka_board.brd, Pletacka_board.sch]
2020-08-12 Update Polyfuse atribute
    [Pletacka_board.brd, Pletacka_board.sch]
2020-08-12 Fix ports rotation
    [Pletacka_board.brd, Pletacka_board.sch]
2020-10-16 Start new version 2.0 in Kicad
    [Pletacka-board.kicad_pcb, Pletacka-board.sch, Pletacka_board.brd, Pletacka_board.sch]
2020-10-16 Create ESP32-TTGO library
    [Pletacka-board.sch]
2020-10-16 Add gitignore
    [Buttons.sch, Leds.sch, Pletacka-board.kicad_pcb, Pletacka-board.sch]
2020-10-16 Add octocoupler library
    [Pletacka-board.kicad_pcb, Pletacka-board.sch]
2020-10-17 Add libraries
    [Buttons.sch, Leds.sch, Optocoupler.sch, Pletacka-board.kicad_pcb, Pletacka-board.sch, Power.sch]
2020-10-17 Add connectors
    [Optocoupler.sch, Pletacka-board.kicad_pcb, Pletacka-board.sch, Power.sch]
2020-10-17 Update some packages, add 3D models
    [Buttons.sch, Leds.sch, Optocoupler.sch, Pletacka-board.kicad_pcb, Pletacka-board.sch, Power.sch]
2020-10-18 Update some packages
    [Pletacka-board.kicad_pcb]
2020-10-18 Routing schema
    [Buttons.sch, Optocoupler.sch, Pletacka-board.kicad_pcb, Pletacka-board.sch, Power.sch]
2020-10-18 Routing board
    [Buttons.sch, Pletacka-board.kicad_pcb, Pletacka-board.sch, Power.sch]
2020-10-18 Add Kicad project file
2020-10-18 Update improve schema and broke board
    [Optocoupler.sch, Pletacka-board.kicad_pcb, Pletacka-board.sch, Power.sch]
2020-10-18 Remove blank sheets
    [Buttons.sch, Leds.sch, Optocoupler.sch, Pletacka-board.sch, Power.sch]
2020-10-19 New routing of board
    [Pletacka-boardR.kicad_pcb, Pletacka-boardR.sch]
2020-10-19 Change buttons and fill ground
    [Pletacka-board.kicad_pcb, Pletacka-board.sch]
2020-10-19 Repair files problem
    [Pletacka-board.kicad_pcb, Pletacka-board.sch, Pletacka-boardR.kicad_pcb]
2020-10-19 Add Kuba Logo
    [Pletacka-board.kicad_pcb]
2020-10-19 Fix small issues
    [Inductor_Selection.ods, Pletacka-board.kicad_pcb]
2020-10-19 Change Inductor
    [Pletacka-board.kicad_pcb, Pletacka-board.sch]
2020-10-19 Testin fabrication export
    [Pletacka-board.kicad_pcb, Pletacka-board.sch]
2020-10-21 Finish board
    [Inductor_Selection.ods, Pletacka-board.kicad_pcb, Pletacka-board.sch]
2020-10-24 Change file structure & add old version 1.0
    [1-cover-assembly.3mf, 3-covers-assembly.3mf, Cover-Top.stl, Cover.stl, Inductor_Selection.ods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]
2020-10-25 Remove buttons - chage board
    [Pletacka-board.kicad_pcb, Pletacka-board.sch]
2020-10-25 Fix multiple files include
    [Board_tester.cpp, Board_tester.hpp, Pletacka.cpp, Pletacka_alive.cpp, Pletacka_config.hpp, Pletacka_display.cpp, Pletacka_status.cpp, Pletacka_status.hpp]
2020-10-26 Add sensor number change by gridUI
2020-10-26 Fix Board tester
2020-10-28 Add few versions
    [3-covers-assembly.3mf]
2020-11-15 Fix Config file name
    [Board_tester.hpp, Pletacka_UI.hpp, Pletacka_alive.hpp, Pletacka_wifi.hpp, main.cpp]
2020-12-12 Add cover, SW-v2.0
    [Button-reset.stl, Button.stl, Cover.stl, Holder-b.stl, Holder-t.stl]
2020-12-12 New set ID button, change behavior
2021-02-27 Add v2.0.2 (fix display, add speed)
    [Board_tester.cpp, Board_tester.hpp, Pletacka.cpp, Pletacka.hpp, Pletacka_UI.cpp, Pletacka_UI.hpp, Pletacka_alive.cpp]
