Pletacka-IoT/Pletacka-board/(notices)

Notices in the files:
parts and their libraries:
Copyright (C) Vlada 2004-2005
